colegioalemanwro2026/wro-futureengineers/videos/youtubelinks.md

# Videos de Demostración
- [1 vuelta completa](https://youtube.com/shorts/-_pdwtU3lxQ?si=ooreduRQsLmnrRoh)
