colegioalemanwro2026/wro-futureengineers/other/arduino-uno-r4.jpg

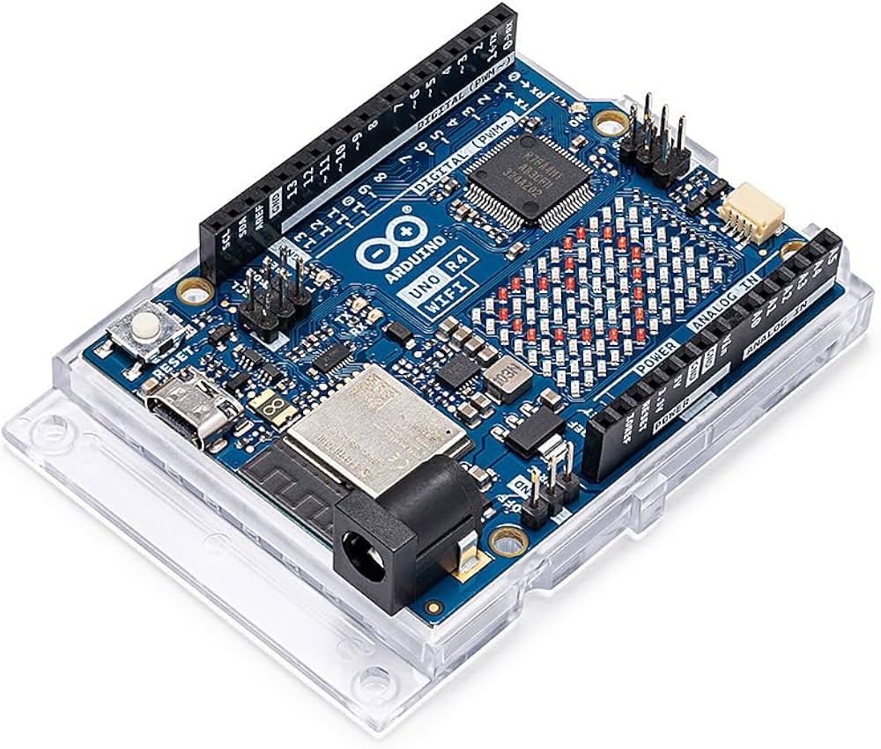
other/arduino-uno-r4.jpg
