colegioalemanwro2026/wro-futureengineers/schemes/flowchart.jpg

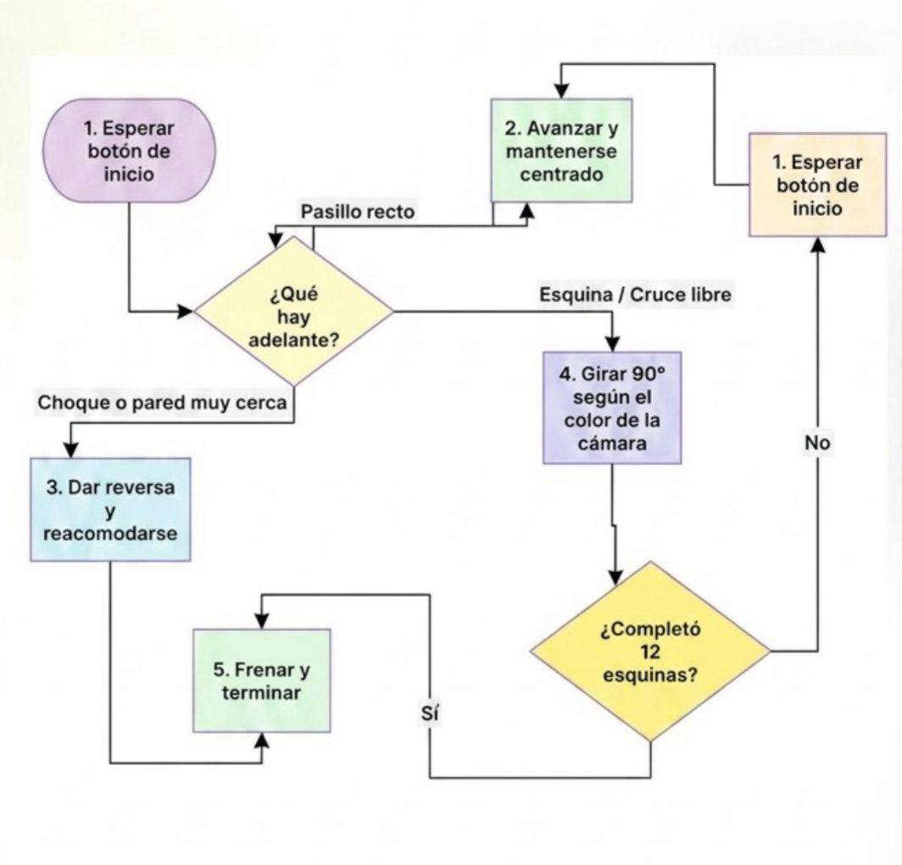
schemes/flowchart.jpg
