colegioalemanwro2026/wro-futureengineers/t-photos/group-encuentro-rob1.jpg

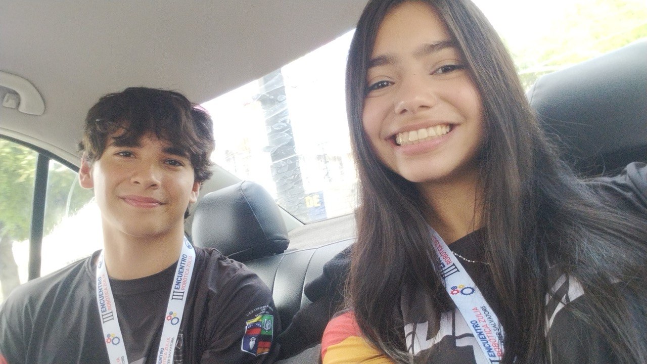
t-photos/group-encuentro-rob1.jpg
