colegioalemanwro2026/wro-futureengineers/t-photos/group-encuentro-rob2.jpg

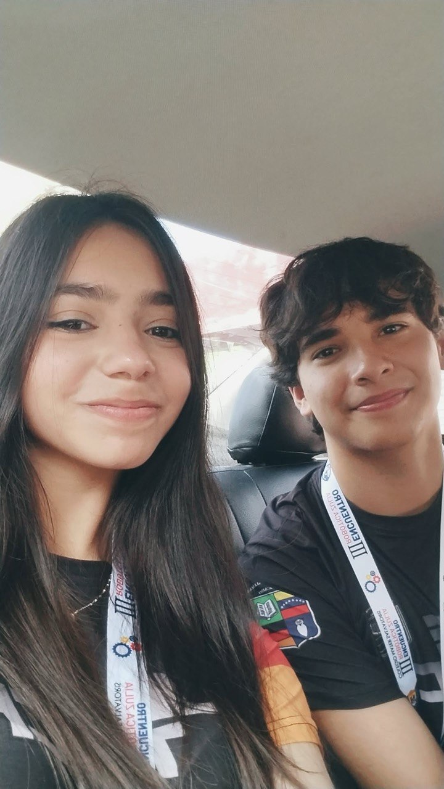
t-photos/group-encuentro-rob2.jpg
