colegioalemanwro2026/wro-futureengineers/t-photos/toghet.jpg

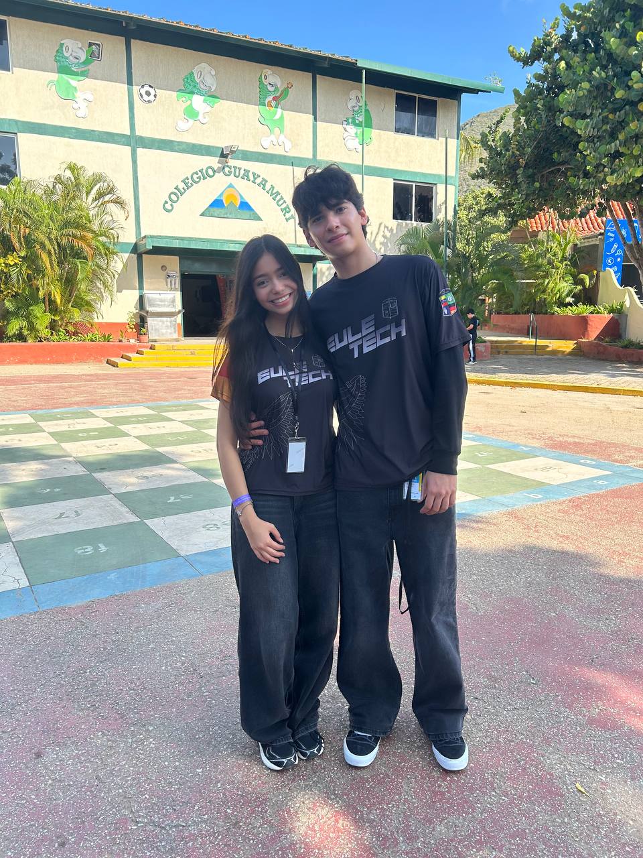
t-photos/toghet.jpg
