colegioalemanwro2026/wro-futureengineers/v-photos/back-moti.jpg

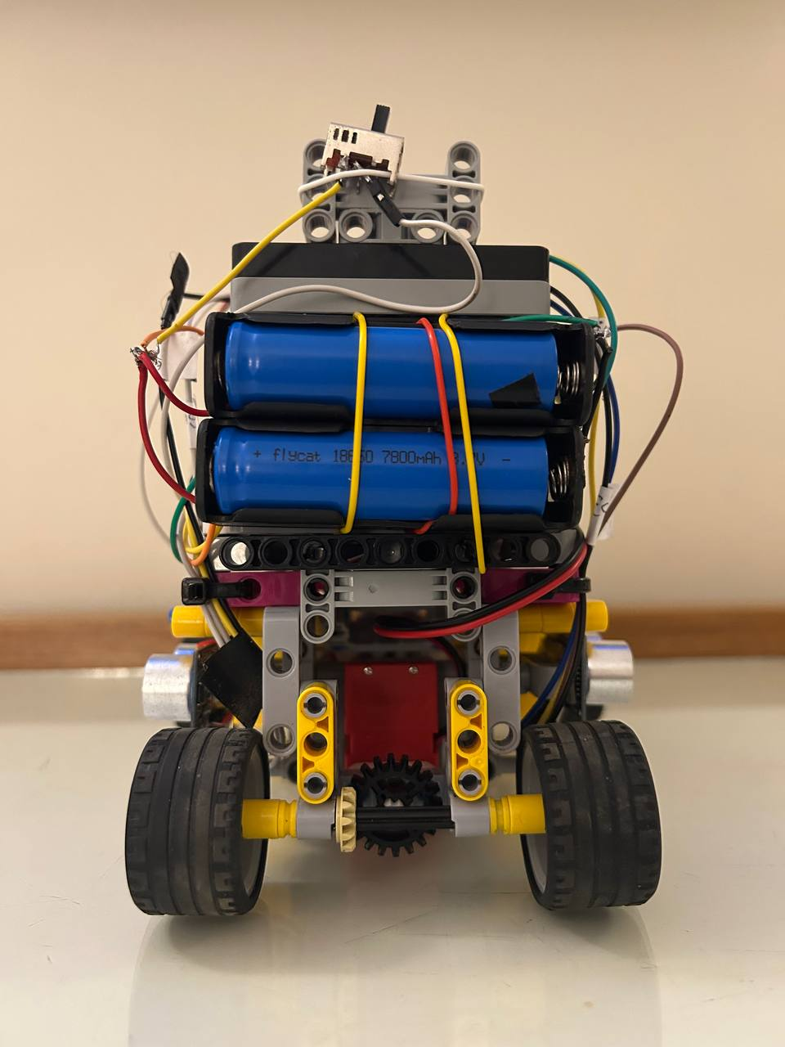
v-photos/back-moti.jpg
