colegioalemanwro2026/wro-futureengineers/v-photos/down-moti.jpg

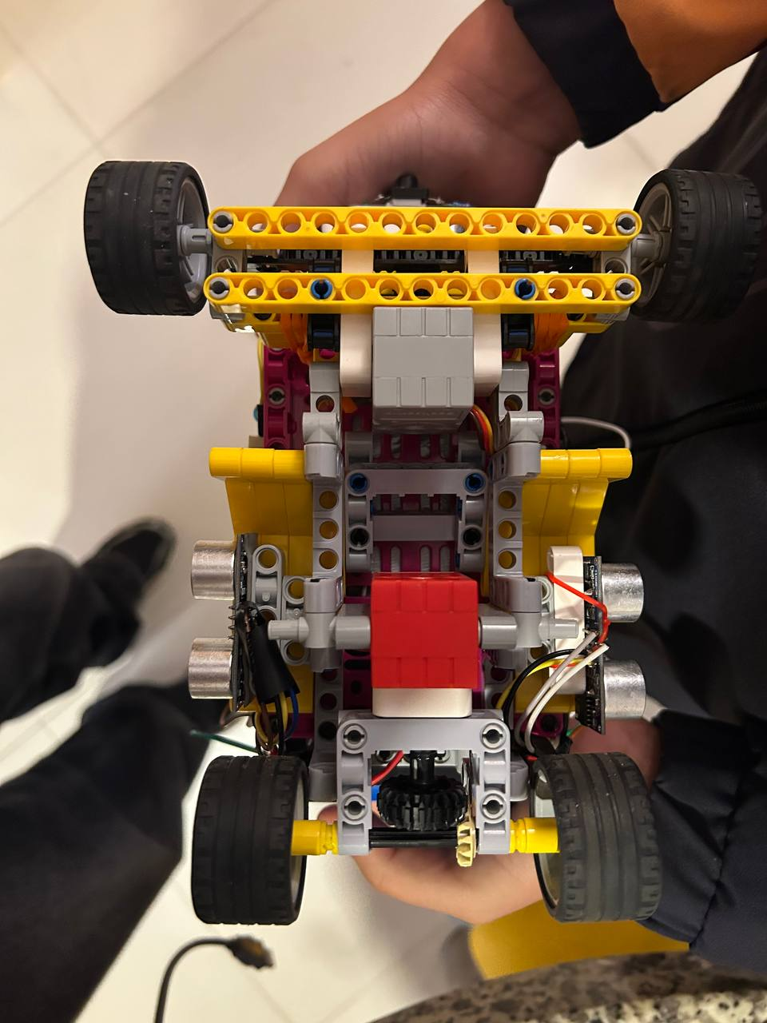
v-photos/down-moti.jpg
