colegioalemanwro2026/wro-futureengineers/v-photos/front-moti.jpg

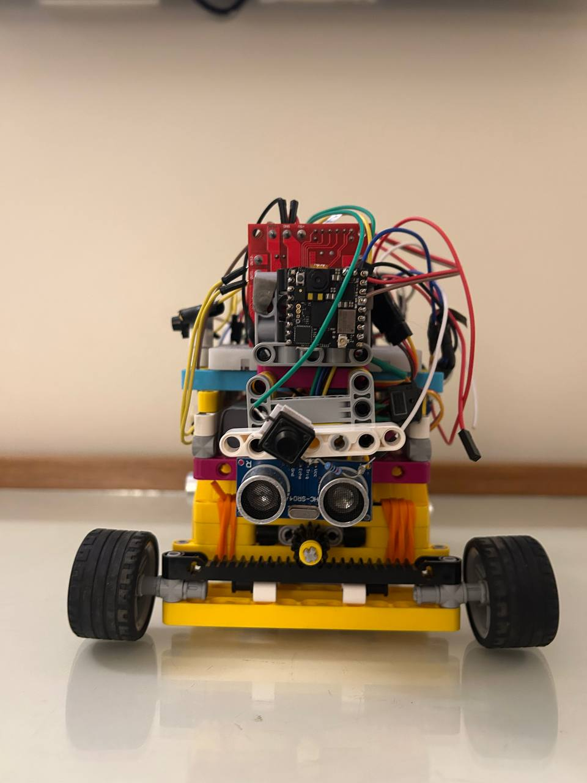
v-photos/front-moti.jpg
