colegioalemanwro2026/wro-futureengineers/v-photos/left-moti.jpg

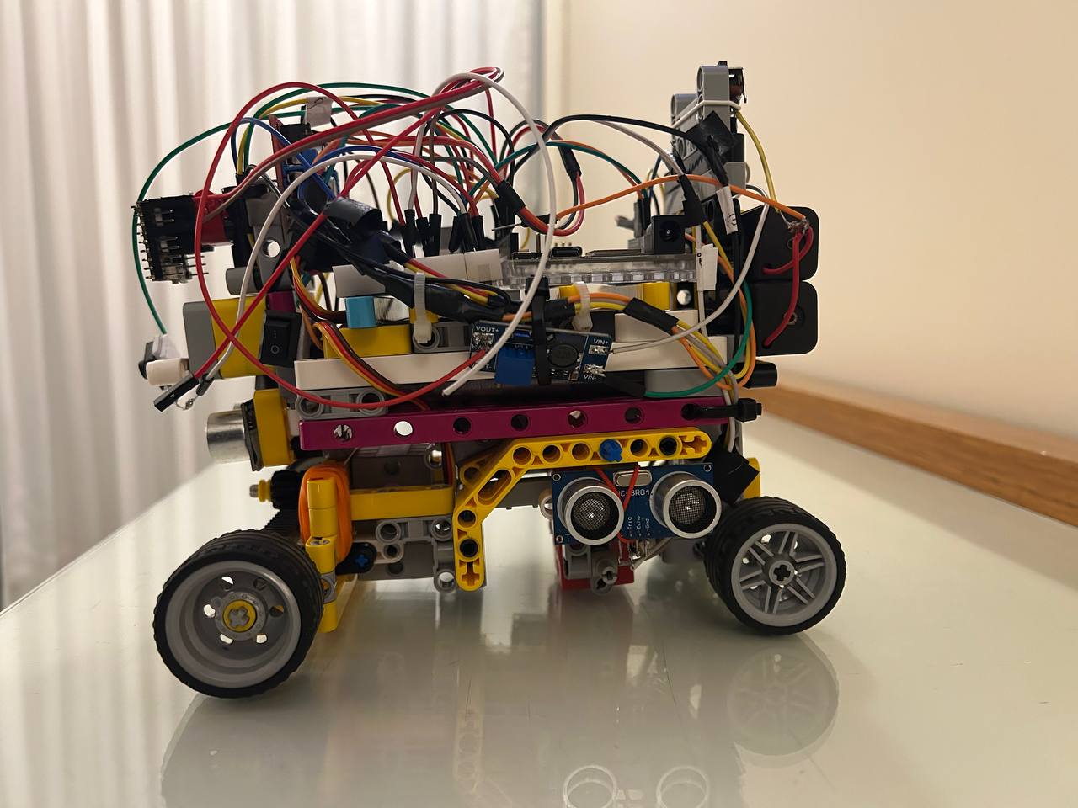
v-photos/left-moti.jpg
