colegioalemanwro2026/wro-futureengineers/v-photos/right-moti.jpg

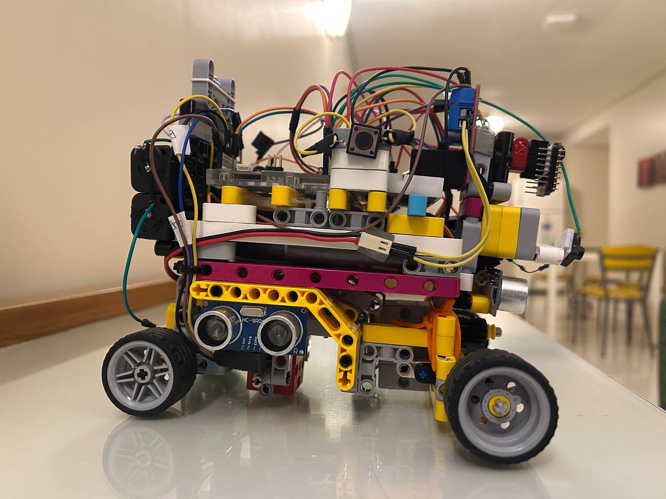
v-photos/right-moti.jpg
