colegioalemanwro2026/wro-futureengineers/v-photos/up-moti.jpg

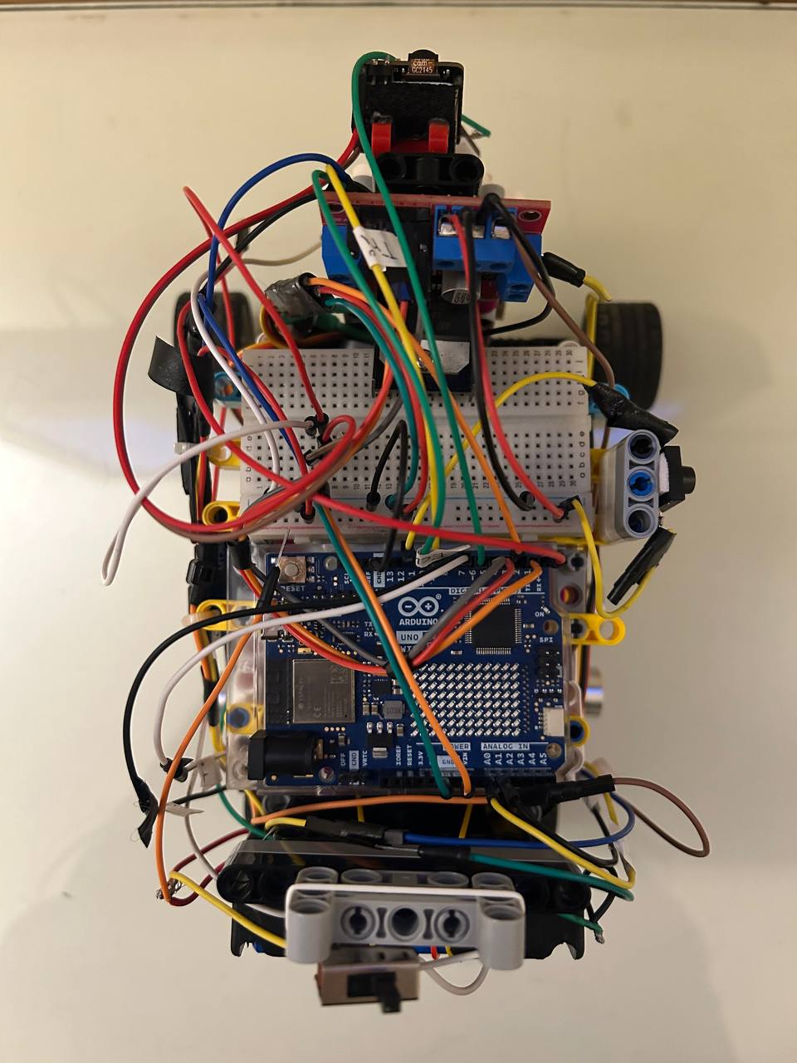
v-photos/up-moti.jpg
