colegioalemanwro2026/wro-futureengineers/(commit log)

2026-08-22 Create arduino
2026-08-29 Create wiring-diagram
2026-08-29 Update and rename wiring-diagram.svg to wiring-diagram
